RodSchz/CM05_CELLS/docs/README.md

# Documentación

| Archivo | Contenido |
|---|---|
| `../CONTRIBUTING.md` | Flujo de trabajo, nomenclatura, checklist de PR |
| `../digital/docs/site_rules.md` | Contrato geométrico de la biblioteca digital |
| `../analog/_template/design.md` | Plantilla de notas de diseño analógico |

## Pendientes de definición

- Fijar los valores `<TBD>` de `site_rules.md` a partir de las reglas de CM05.
- Escribir las reglas DRC en `pdk/tech/drc/cm05_drc.lydrc`.
- Definir el flujo de LVS en `pdk/tech/lvs/`.
- Incorporar los modelos SPICE por corner en `pdk/tech/models/`.
- Traer `CIDESI_CM05.xs` (XSection) desde el repositorio del PDK a `pdk/`.
