RodSchz/CM05_CELLS/digital/pads/README.md

# Celdas de E/S

Pads y celdas de interfaz. **Exentas del contrato de fila**: no se colocan en filas.

| Celda | Función | Ancho (µm) | Alto (µm) | Pines |
|---|---|---:|---:|---:|
| [`CORNER`](CORNER/cell.yaml) | Celda de esquina del padframe | 232.5 | 232.5 | 0 |
| [`Outbuffer`](Outbuffer/cell.yaml) | Buffer de salida hacia pad | 265.0 | 232.5 | 4 |
| [`PADGND`](PADGND/cell.yaml) | Pad de tierra GND | 515.0 | 390.0 | 0 |
| [`PADIGI`](PADIGI/cell.yaml) | Pad de entrada/salida de proposito general | 265.0 | 392.5 | 0 |
| [`PADVDD`](PADVDD/cell.yaml) | Pad de alimentacion VDD | 515.0 | 410.0 | 0 |
