RodSchz/CM05_CELLS/blocks/Full_adder/ltspice/Full_adder.asc

X1: HA
X2: HA
X3: OR2X1
Named nets: A, B, Cin, SUM, Cout, VDD, 0
