RodSchz/CM05_CELLS/blocks/Full_adder/ltspice/Full_adder_sim.asc

C1: cap; {CL}
C2: cap; {CL}
X1: Full_adder
Named nets: SUM, Cout, 0, A, B, Cin
VA A 0 PULSE(5 0 0 10n 10n {Tp/2} {Tp})
VB B 0 PULSE(5 0 0 10n 10n {Tp} {2*Tp})
.tran {5*Tp}
.global VDD
.param CL=0.5p
*.step param CL list 1p 10p 100p
.param fo=1k Tp=1/fo
.options gmin=1e-10
.options abstol=1e-10
.options reltol=0.003
.options cshunt=1e-15
VS VDD GND 5
.inc ../../../pdk/tech/models/CM05_models.lib
VC Cin 0 PULSE(5 0 0 10n 10n {2*Tp} {4*Tp})
