RodSchz/CM05_CELLS/blocks/HA/ltspice/HA.asc

X1: XOR2X1
X2: AND2X1
Named nets: A, B, SUM, Cout, VDD, 0
