RodSchz/CM05_CELLS/blocks/NOT_CHAIN/ltspice/NOT_CHAIN.asc

X1: NOT
X2: NOT
X3: NOT
X4: NOT
X5: NOT
X6: NOT
X7: Buffer
Named nets: A, M5, O5, VDD, 0, buffered, o1
.inc ../../../pdk/tech/models/CM05_models.lib
VA A 0 PULSE(0 5 0 1n 1n {Tp/2} {Tp})
.tran {5*Tp}
.global VDD
.param CL=1p
*.step param CL list 1p 10p 100p
.param fo=10MEG Tp=1/fo
.options gmin=1e-10
.options abstol=1e-10
.options reltol=0.003
.options cshunt=1e-15
VDD VDD GND 5
