RodSchz/CM05_CELLS/digital/cells/#_INFRA_/ltspice/INFRA_tb.asc

V1: voltage; {Vdd}
V2: voltage; PULSE(0 {Vdd} 2n {t_edge} {t_edge} 40n 80n)
X1: NOT
X2: NOT
X3: NOT_Wp_50
X4: NOT_Wp_50
X5: NOR2X1
X6: NOR2X1_Wp_100
X7: NOT
X8: NOT
Named nets: 0, OUT_INV25, OUT_INV50, OUT_NOR100, OUT_NOR50, IN, VDD
.options gmin=1e-10
.options abstol=1e-10
.options reltol=0.003
.options cshunt=1e-15
.inc ..\\..\\..\\..\\pdk\\tech\\models\\CM05_models.lib
NOT P_w = 25
NOT P_w = 50
NOR2X1  P_w = 50
NOR2X1  P_w = 100
.tran 100n
.param Vdd=5 Vhi={Vdd * 0.9} Vlo={Vdd*0.1} t_edge=0.1n
* --- MEDICIONES PARA INV25 ---
.meas tran tr_inv25 TRIG V(OUT_INV25) VAL={Vlo} RISE=1 TARG V(OUT_INV25) VAL={Vhi} RISE=1
.meas tran tf_inv25 TRIG V(OUT_INV25) VAL={Vhi} FALL=1 TARG V(OUT_INV25) VAL={Vlo} FALL=1
* --- MEDICIONES PARA INV50 ---
.meas tran tr_inv50 TRIG V(OUT_INV50) VAL={Vlo} RISE=1 TARG V(OUT_INV50) VAL={Vhi} RISE=1
.meas tran tf_inv50 TRIG V(OUT_INV50) VAL={Vhi} FALL=1 TARG V(OUT_INV50) VAL={Vlo} FALL=1
* --- MEDICIONES PARA NOR50 ---
.meas tran tr_nor50 TRIG V(OUT_NOR50) VAL={Vlo} RISE=1 TARG V(OUT_NOR50) VAL={Vhi} RISE=1
.meas tran tf_nor50 TRIG V(OUT_NOR50) VAL={Vhi} FALL=1 TARG V(OUT_NOR50) VAL={Vlo} FALL=1
* --- MEDICIONES PARA NOR100 ---
.meas tran tr_nor100 TRIG V(OUT_NOR100) VAL={Vlo} RISE=1 TARG V(OUT_NOR100) VAL={Vhi} RISE=1
.meas tran tf_nor100 TRIG V(OUT_NOR100) VAL={Vhi} FALL=1 TARG V(OUT_NOR100) VAL={Vlo} FALL=1
