RodSchz/CM05_CELLS/digital/cells/#_INFRA_/ltspice/NOR2X1_Wp_100.asc

M1: nmos4; CIDNMOS; l=5u w=10u
M2: pmos4; CIDPMOS; l=5u w=100u
M3: nmos4; CIDNMOS; l=5u w=10u
M4: pmos4; CIDPMOS; l=5u w=100u
Named nets: A, B, OUT, V+, V-
