RodSchz/CM05_CELLS/digital/cells/#_INFRA_/ltspice/NOT_Wp_50.asc

M1: nmos4; CIDNMOS; l=5u w=10u
M2: pmos4; CIDPMOS; l=5u w=50u
Named nets: IN, OUT, V-, V+
