RodSchz/CM05_CELLS/digital/cells/AND2X1/ltspice/AND2X1.asc

M1: nmos4; CIDNMOS; l=5u w=15u
M2: pmos4; CIDPMOS; l=5u w=50u
M3: nmos4; CIDNMOS; l=5u w=15u
M4: pmos4; CIDPMOS; l=5u w=50u
M5: nmos4; CIDNMOS; l=5u w=15u
M6: pmos4; CIDPMOS; l=5u w=50u
Named nets: A, B, OUT, GND, VDD, 0
