RodSchz/CM05_CELLS/analog/cells/cmirror/ltspice/cmirror_sim.asc

G1: g; 1
G2: g; 1
U1: cmirror_lay
V1: voltage; 5
V2: voltage; 1m
X1: cmirror
Named nets: 0, OUT, ctrl
.op
.inc ../../../../pdk/tech/models/CM05_models.lib
.dc V2 0 5m 0.1m
.inc cmirror_lay.cir
