RodSchz/CM05_CELLS/digital/cells/#_INFRA_/ltspice/NOT.asc

M1: nmos4; CIDNMOS; l=5u w=10u
M2: pmos4; CIDPMOS; l=5u w=25u
Named nets: IN, OUT, V-, V+
