RodSchz/CM05_CELLS/digital/cells/Buffer/ltspice/Buffer.asc

M1: nmos4; CIDNMOS; l=5u w=10u
M2: pmos4; CIDPMOS; l=5u w=25u
M3: nmos4; CIDNMOS; l=5u w=10u
M4: pmos4; CIDPMOS; l=5u w=25u
Named nets: IN, OUT, V-, V+
