RodSchz/CM05_CELLS/digital/cells/NAND2X1/ltspice/NAND2X1_sim.asc

C1: cap; {CL}
X1: NAND2X1
Named nets: A, B, 0, Y
.inc ../../../../pdk/tech/models/CM05_models.lib
VA A GND PULSE(5 0 {Tp} 10n 10n {Tp/2} {Tp})
VB B GND PULSE(5 0 {Tp} 10n 10n {Tp} {2*Tp})
VS VDD GND 5
.tran {5*Tp}
.global VDD
.param CL=1p
.step param CL list 1p 10p 100p
.param fo=100k Tp=1/fo
