RodSchz/CM05_CELLS/digital/cells/NAND2X1/ltspice/NAND2X1_simAC.asc

C1: cap; {CL}
X1: NAND2X1
Named nets: A, B, 0, Y
.inc ../../../../pdk/tech/models/CM05_models.lib
VIN MEAS GND 0 AC 1
E1 B GND MEAS GND 1
E2 A GND MEAS GND 1
VS VDD GND 5
.global VDD
.param CL=1p
.ac dec 10 1 100MEG
