RodSchz/CM05_CELLS/digital/cells/OR2X1/ltspice/OR2X1.asc

M1: nmos4; CIDNMOS; l=5u w=10u
M2: pmos4; CIDPMOS; l=5u w=25u
M3: nmos4; CIDNMOS; l=5u w=10u
M4: pmos4; CIDPMOS; l=5u w=25u
M5: nmos4; CIDNMOS; l=5u w=10u
M6: pmos4; CIDPMOS; l=5u w=25u
Named nets: A, B, V+, V-, OUT
