RodSchz/CM05_CELLS/digital/cells/XNOR2X1/ltspice/XNOR2x1.asc

M1: nmos4; CIDNMOS; l=5u w=10u
M2: pmos4; CIDPMOS; l=5u w=25u
M3: nmos4; CIDNMOS; l=5u w=10u
M4: pmos4; CIDPMOS; l=5u w=25u
M5: nmos4; CIDNMOS; l=5u w=10u
M6: nmos4; CIDNMOS; l=5u w=10u
M7: pmos4; CIDPMOS; l=5u w=25u
M8: pmos4; CIDPMOS; l=5u w=25u
M9: pmos4; CIDPMOS; l=5u w=25u
M10: nmos4; CIDNMOS; l=5u w=10u
Named nets: A, V+, V-, B, OUT
