RodSchz/CM05_CELLS/analog/cells/cmirror/ltspice/cmirror.asc

M1: nmos4; CIDNMOS; l=10u w=100u
M2: nmos4; CIDNMOS; l=10u w=100u
Named nets: P1, P2, COM
