RodSchz/CM05_CELLS/_legacy/Prueba01/Prueba01.kicad_pcb

## KiCad design Documentation/final_project.kicad_sch


Parts:
ADXL345: U2
D1: NeoPixel_THT
J1: OLED
J2: BAT
R1: 330Ω
SW1: RotaryEncoder_Switch
SW2: SW_SPDT
U1: Conn_01x07_Pin

Connections:
unnamed: ADXL345.GND (Pin_1), D1.2 (GND), J1.GND (Pin_2), J2.2, SW1.C, SW1.S2, U1.GND (Pin_2)
unnamed: ADXL345.SCL (Pin_4), J1.SCL (Pin_4), U1.D5 (Pin_6)
unnamed: ADXL345.SDA (Pin_3), J1.SDA (Pin_3), U1.D4 (Pin_5)
unnamed: ADXL345.VCC (Pin_2), J1.VCC (Pin_1), U1.3V3 (Pin_3)
unnamed: D1.3 (VDD), SW2.1 (A), U1.5V (D0_/_GPIO0)
unnamed: D1.4 (DIN), R1.1, SW1.A, U1.D6 (Pin_7)
unnamed: J2.1, SW2.2 (B)
unnamed: R1.2, U1.D10 (Pin_4)
unnamed: SW1.B, U1.D9 (Pin_5)
unnamed: SW1.S1, U1.D7 (Pin_7)

Notes on the sheet:
U1 - XIAO ESP32-C3
