RodSchz/CM05_CELLS/(commit log)

2026-08-23 Estructura inicial, contrato de fila y migracion de 23 celdas CM05
    [Prueba01.kicad_pcb, Prueba01.kicad_sch, cap_test.sch]
2026-08-24 cmirror: banco de pruebas ngspice, reestructura a ltspice/ y modelos sincronizados con el PDK
2026-08-24 digital: migra esquematicos de 8 compuertas y agrega sistema de bloqueos
2026-08-24 docs: manual de operacion con roles, ciclo de vida y flujo en GitHub
2026-09-22 README: nota de estado del repositorio (#3)
    Squash and merge de nota de estado de repositorio
2026-09-22 Se agrega guia de inicio (#4)
    Incorporación de guía de inicio
2026-09-22 Se agrega tutorial para atención de issues
2026-10-01 Fix/adn2x1 contrato fila (#11)
    * Corrección de layout para cumplir en origen y altura
    * Corrección de frontera de AND2X1, corrección de esquematico con tamaños de layout y extracción de netlist. Actualización de archivo yaml
    [cell.yaml]
2026-10-09 Fix/infra conversion dimenciones (#16)
    * INFRA: se realizo el esquematico de INFRA para comprobar cual de las 3 reglas cumplia, se agrego un documento donde se espesifica que regla cumple y porque con prueba de simulacion
    * INFRA: se realizo la revision con Dr. Rodolfo
2026-10-22 Reorganiza scripts: verify/{digital,analog} y documenta el proposito de cada carpeta
2026-11-05 Fix/scrips analo (#30)
    * Se agrego el scripts del Cmirror_1aN
    * Se agrego el Scripts de Cmirror_1N
2026-11-05 Fix/scrips verify (#31)
    * Commit_1: Se agregaron los scrips generales para, celdas In1, In2, In3 y tristate
    * Commit_2: Se agrego scrips para FFD y Latch (scrips espesificos)
